rcls/blinky/blinky.kicad_pcb

## KiCad design blinky.kicad_pcb (2025-12-23)

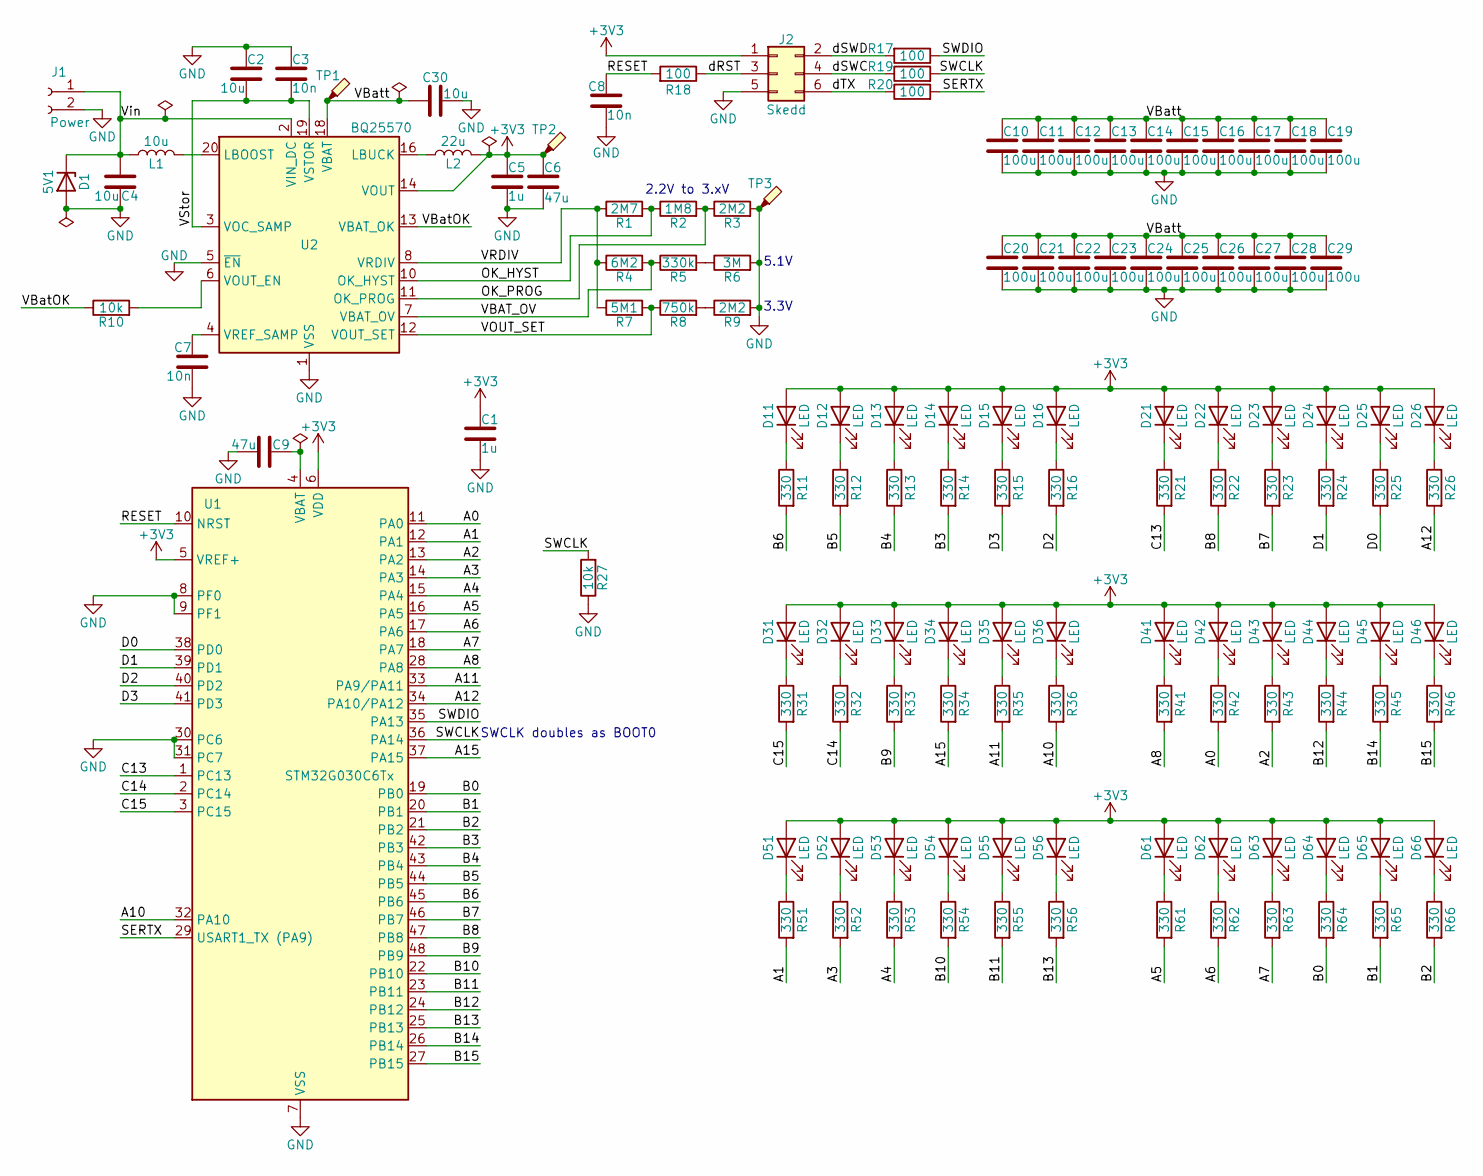
[picture p1: schematic blinky.kicad_sch]

Parts:
C1, C5: 1u; C_0402_1005Metric; LCSC C52923
C2, C4, C30: 10u; C_0603_1608Metric; LCSC C19702
C3, C7, C8: 10n; C_0402_1005Metric; LCSC C15195
C6, C9: 47u; C_0805_2012Metric; LCSC C16780
C10, C11, C12, C13, C14, C15, C16, C17, C18, C19, C20, C21, C22, C23, C24, C25, C26, C27, C28, C29: 100u; C_1206_3216Metric; LCSC C15008
D1: 5V1; D_SOD-323; LCSC C19077434
D11, D12, D13, D14, D15, D16, D21, D22, D23, D24, D25, D26, D31, D32, D33, D34, D35, D36, D41, D42, D43, D44, D45, D46, D51, D52, D53, D54, D55, D56, D61, D62, D63, D64, D65, D66: LED; LED_0805_2012Metric
J1: Power; PinSocket_1x02_P2.54mm_Vertical
J2: Skedd; Skedd6
L1: 10u; L_1008_2520Metric-Adjusted; LCSC C18221303
L2: 22u; L_1008_2520Metric-Adjusted; LCSC C18221305
R1: 2M7; R_0603_1608Metric
R2: 1M8; R_0603_1608Metric
R3, R9: 2M2; R_0603_1608Metric; LCSC C22938
R4: 6M2; R_0603_1608Metric
R5: 330k; R_0603_1608Metric; LCSC C23137
R6: 3M; R_0603_1608Metric; LCSC C23156
R7: 5M1; R_0603_1608Metric; LCSC C13320
R8: 750k; R_0603_1608Metric; LCSC C23240
R10, R27: 10k; R_0402_1005Metric; LCSC C25744
R11, R12, R13, R14, R15, R16, R21, R22, R23, R24, R25, R26, R31, R32, R33, R34, R35, R36, R41, R42, R43, R44, R45, R46, R51, R52, R53, R54, R55, R56, R61, R62, R63, R64, R65, R66: 330; R_0402_1005Metric; LCSC C25104
R17, R18, R19, R20: 100; R_0402_1005Metric; LCSC C25076
TP1, TP2, TP3: TestPoint_Probe; TestPoint
U1: STM32G030C6Tx; LQFP-48_7x7mm_P0.5mm; LCSC C529329
U2: BQ25570; QFN-20-1EP_3.5x3.5mm_P0.5mm_EP2x2mm; LCSC C506250

Connections:
+3V3: C1.1, C5.1, C6.1, D11.2 (A), D12.2 (A), D13.2 (A), D14.2 (A), D15.2 (A), D16.2 (A), D21.2 (A), D22.2 (A), D23.2 (A), D24.2 (A), D25.2 (A), D26.2 (A), D31.2 (A), D32.2 (A), D33.2 (A), D34.2 (A), D35.2 (A), D36.2 (A), D41.2 (A), D42.2 (A), D43.2 (A), D44.2 (A), D45.2 (A), D46.2 (A), D51.2 (A), D52.2 (A), D53.2 (A), D54.2 (A), D55.2 (A), D56.2 (A), D61.2 (A), D62.2 (A), D63.2 (A), D64.2 (A), D65.2 (A), D66.2 (A), J2.1, L2.2, TP2.1, U1.5 (VREF+), U1.6 (VDD), U2.14 (VOUT)
/A0: R42.2, U1.11 (PA0)
/A1: R51.2, U1.12 (PA1)
/A2: R43.2, U1.13 (PA2)
/A3: R52.2, U1.14 (PA3)
/A4: R53.2, U1.15 (PA4)
/A5: R61.2, U1.16 (PA5)
/A6: R62.2, U1.17 (PA6)
/A7: R63.2, U1.18 (PA7)
/A8: R41.2, U1.28 (PA8)
/A10: R36.2, U1.32 (PA10)
/A11: R35.2, U1.33 (PA9/PA11)
/A12: R26.2, U1.34 (PA10/PA12)
/A15: R34.2, U1.37 (PA15)
/B0: R64.2, U1.19 (PB0)
/B1: R65.2, U1.20 (PB1)
/B2: R66.2, U1.21 (PB2)
/B3: R14.2, U1.42 (PB3)
/B4: R13.2, U1.43 (PB4)
/B5: R12.2, U1.44 (PB5)
/B6: R11.2, U1.45 (PB6)
/B7: R23.2, U1.46 (PB7)
/B8: R22.2, U1.47 (PB8)
/B9: R33.2, U1.48 (PB9)
/B10: R54.2, U1.22 (PB10)
/B11: R55.2, U1.23 (PB11)
/B12: R44.2, U1.24 (PB12)
/B13: R56.2, U1.25 (PB13)
/B14: R45.2, U1.26 (PB14)
/B15: R46.2, U1.27 (PB15)
/C13: R21.2, U1.1 (PC13)
/C14: R32.2, U1.2 (PC14)
/C15: R31.2, U1.3 (PC15)
/D0: R25.2, U1.38 (PD0)
/D1: R24.2, U1.39 (PD1)
/D2: R16.2, U1.40 (PD2)
/D3: R15.2, U1.41 (PD3)
/OK_HYST: R1.2, R2.1, U2.10 (OK_HYST)
/OK_PROG: R2.2, R3.1, U2.11 (OK_PROG)
/RESET: C8.1, R18.2, U1.10 (NRST)
/SERTX: R20.2, U1.29 (USART1_TX (PA9))
/SWCLK: R19.2, R27.2, U1.36 (PA14)
/SWDIO: R17.1, U1.35 (PA13)
/VBAT_OV: R4.2, R5.1, U2.7 (VBAT_OV)
/VBatOK: R10.1, U2.13 (VBAT_OK)
/VBatt: C10.1, C11.1, C12.1, C13.1, C14.1, C15.1, C16.1, C17.1, C18.1, C19.1, C20.1, C21.1, C22.1, C23.1, C24.1, C25.1, C26.1, C27.1, C28.1, C29.1, C30.1, TP1.1, U2.18 (VBAT)
/VOUT_SET: R7.2, R8.1, U2.12 (VOUT_SET)
/VRDIV: R1.1, R4.1, R7.1, U2.8 (VRDIV)
/VStor: C2.2, C3.2, U2.3 (VOC_SAMP), U2.19 (VSTOR)
/Vin: C4.1, D1.1 (K), J1.1, L1.1, U2.2 (VIN_DC)
/dRST: J2.3, R18.1
/dSWC: J2.4, R19.1
/dSWD: J2.2, R17.2
/dTX: J2.6, R20.1
GND: C1.2, C2.1, C3.1, C4.2, C5.2, C6.2, C7.2, C8.2, C9.1, C10.2, C11.2, C12.2, C13.2, C14.2, C15.2, C16.2, C17.2, C18.2, C19.2, C20.2, C21.2, C22.2, C23.2, C24.2, C25.2, C26.2, C27.2, C28.2, C29.2, C30.2, D1.2 (A), J1.2, J2.5, R3.2, R6.2, R9.2, R27.1, TP3.1, U1.7 (VSS), U1.8 (PF0), U1.9 (PF1), U1.30 (PC6), U1.31 (PC7), U2.1 (VSS), U2.5 (~EN), U2.9 (VSS), U2.15 (VSS), U2.17 (VSS), U2.21 (VSS)
unnamed: D11.1 (K), R11.1
unnamed: D12.1 (K), R12.1
unnamed: D13.1 (K), R13.1
unnamed: D14.1 (K), R14.1
unnamed: D15.1 (K), R15.1
unnamed: D16.1 (K), R16.1
unnamed: D21.1 (K), R21.1
unnamed: D22.1 (K), R22.1
unnamed: D23.1 (K), R23.1
unnamed: D24.1 (K), R24.1
unnamed: D25.1 (K), R25.1
unnamed: D26.1 (K), R26.1
unnamed: D31.1 (K), R31.1
unnamed: D32.1 (K), R32.1
unnamed: D33.1 (K), R33.1
unnamed: D34.1 (K), R34.1
unnamed: D35.1 (K), R35.1
unnamed: D36.1 (K), R36.1
unnamed: D41.1 (K), R41.1
unnamed: D42.1 (K), R42.1
unnamed: D43.1 (K), R43.1
unnamed: D44.1 (K), R44.1
unnamed: D45.1 (K), R45.1
unnamed: D46.1 (K), R46.1
unnamed: D51.1 (K), R51.1
unnamed: D52.1 (K), R52.1
unnamed: D53.1 (K), R53.1
unnamed: D54.1 (K), R54.1
unnamed: D55.1 (K), R55.1
unnamed: D56.1 (K), R56.1
unnamed: D61.1 (K), R61.1
unnamed: D62.1 (K), R62.1
unnamed: D63.1 (K), R63.1
unnamed: D64.1 (K), R64.1
unnamed: D65.1 (K), R65.1
unnamed: D66.1 (K), R66.1
unnamed: R5.2, R6.1
unnamed: R8.2, R9.1
unnamed: C9.2, U1.4 (VBAT)
unnamed: L1.2, U2.20 (LBOOST)
unnamed: L2.1, U2.16 (LBUCK)
unnamed: R10.2, U2.6 (VOUT_EN)
unnamed: C7.1, U2.4 (VREF_SAMP)

Notes on the sheet:
5.1V
3.3V
2.2V to 3.xV
SWCLK doubles as BOOT0

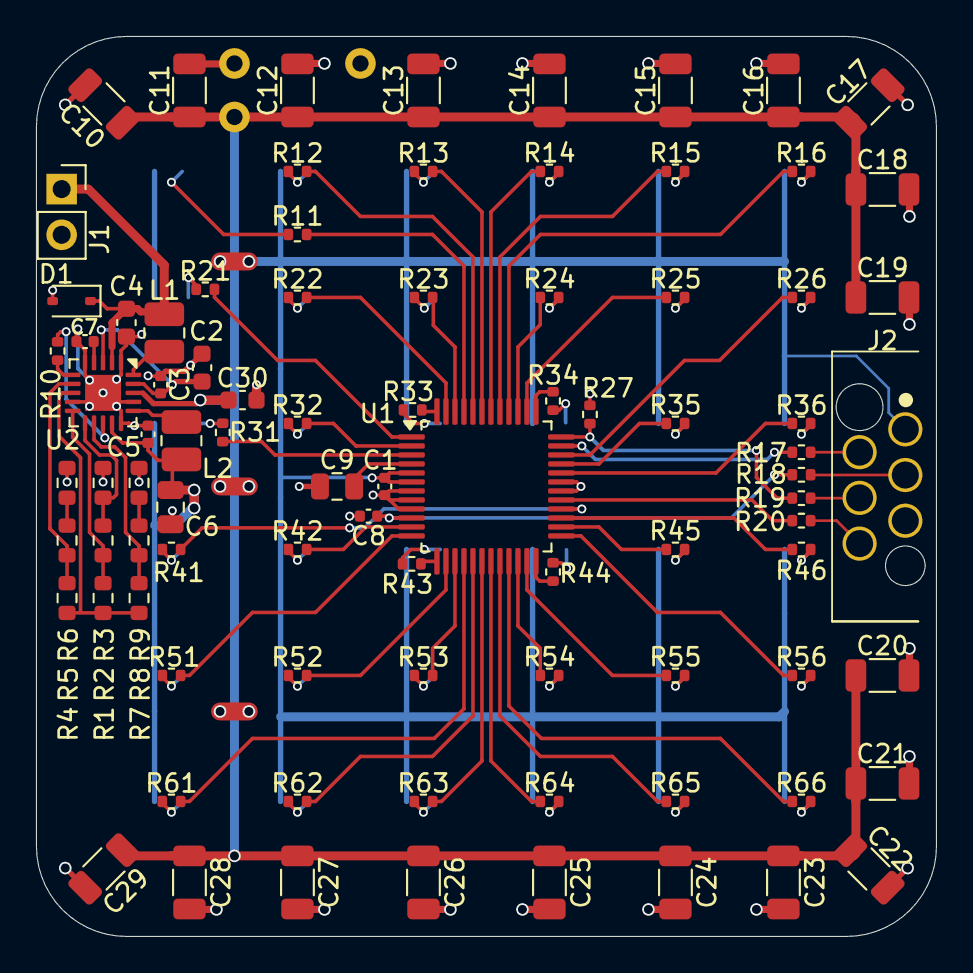
[picture p2: board blinky.kicad_pcb from above]

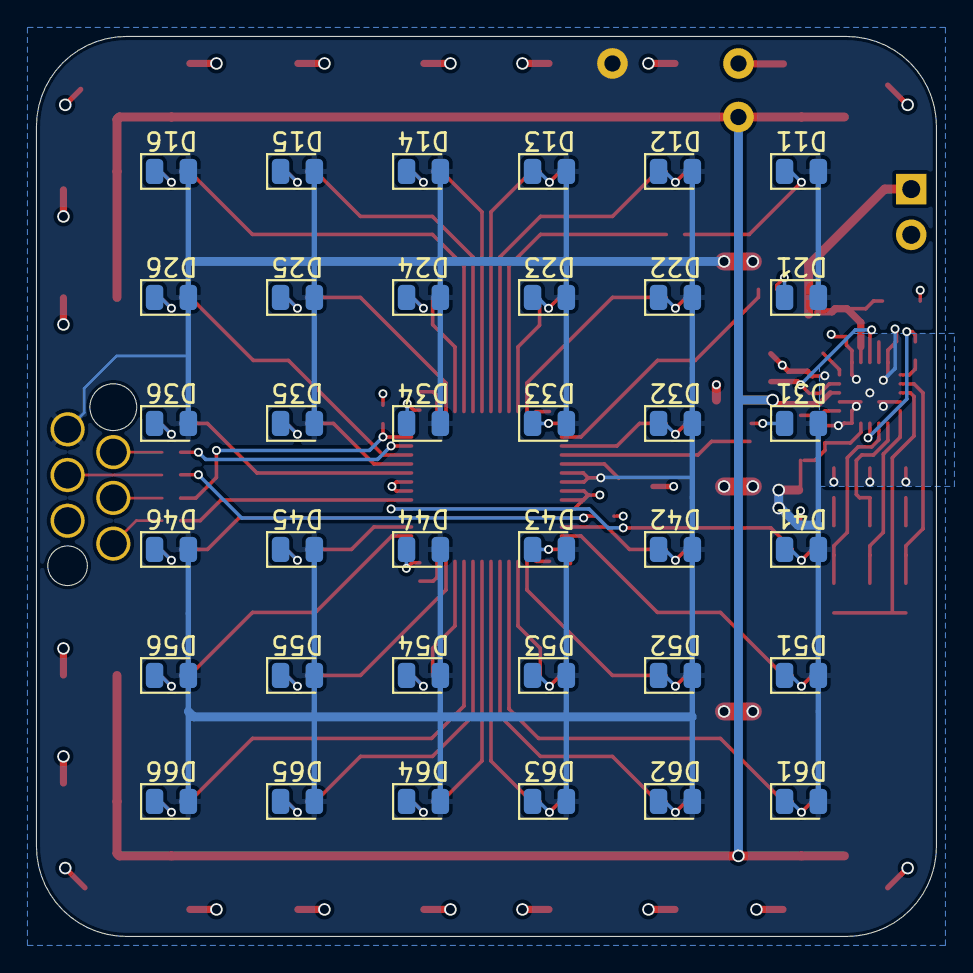
[picture p3: board blinky.kicad_pcb from below]

Board: 4 copper layers, 50.0 x 50.0 mm, 127 parts (37 on the bottom side), 98 nets.
