rcls/blinky/src/leds.rs

pub static COLUMNS: [[u64; 64]; 6] = gen_columns();

const fn gen_columns() -> [[u64; 64]; 6] {
    let mut value = [[0; _]; _];
    let mut column = 0;
    while column < 6 {
        let mut bits = 0;
        while bits < 64 {
            let val = &mut value[column][bits];
            let mut row = 0;
            while row < 6 {
                if bits & (1 << row) != 0 {
                    *val |= 1 << LEDS[column + 30 - row * 6];
                }
                row += 1;
            }
            bits += 1;
        }
        column += 1;
    }
    value
}

/// Bit mask of LED GPIOs.  One entry per-port, successive bits are LEDs.
pub const PORT_BITS: [u32; 4] = PORT_STUFF.0;
/// Like PORT_BITS, except only even numbered bits are used.
pub const PORT_BIT2: [u32; 4] = PORT_STUFF.1;
/// Like PORT_BITS, except only every fourth bit is used.
pub const _PORT_BIT4: [[u32; 2]; 4] = PORT_STUFF.2;

/// Return GPIOA ..= GPIOD based on n.
pub fn gpio(n: usize) -> &'static stm32g030::gpiob::RegisterBlock {
    let address = 0x5000_0000 + 0x400 * n as usize;
    unsafe {&* (address as *const stm32g030::gpiob::RegisterBlock)}
}

pub const PORT_STUFF: ([u32; 4], [u32; 4], [[u32; 2]; 4]) = {
    let mut mask = [0; 4];
    let mut bit2 = [0; 4];
    let mut bit4 = [[0, 2]; 4];
    let mut i = 0;
    while i < LEDS.len() {
        let led = LEDS[i] as usize;
        mask[led / 16] |= 1 << led % 16;
        bit2[led / 16] |= 1 << led % 16 * 2;
        bit4[led / 16][led % 16 / 8] |= 1 << led % 8 * 4;
        i += 1;
    }
    (mask, bit2, bit4)
};

pub const LED_ALL: u64 = {
    let mut all = 0;
    let mut i = 0;
    while i < LEDS.len() {
        all |= 1 << LEDS[i];
        i += 1;
    }
    all
};

const A: u8 = 0;
const B: u8 = 16;
const C: u8 = 32;
const D: u8 = 48;

// First items in the array are D11 .. D16.
pub static LEDS: [u8; 36] = [
    B +  6, B +  5, B + 4, B +  3, D +  3, D +  2,
    C + 13, B +  8, B + 7, D +  1, D +  0, A + 12,
    C + 15, C + 14, B + 9, A + 15, A + 11, A + 10,
    A +  8, A +  0, A + 2, B + 12, B + 14, B + 15,
    A +  1, A +  3, A + 4, B + 10, B + 11, B + 13,
    A +  5, A +  6, A + 7, B +  0, B +  1, B +  2,
];

#[test]
fn unique() {
    let mut leds = LEDS;
    leds.sort();
    for i in 1 .. leds.len() {
        assert_ne!(leds[i], leds[i - 1]);
    }
}

#[test]
fn bit_counts() {
    assert_eq!(LED_ALL.count_ones(), 36);
}

#[test]
fn sane_columns() {
    for column in COLUMNS {
        for (i, x) in column.iter().enumerate() {
            assert_eq!(i.count_ones(), x.count_ones());
            for (j, y) in column.iter().enumerate() {
                assert_eq!(column[i | j], x | y);
            }
        }
    }
}
