rcls/blinky/src/blinky.rs

#![cfg_attr(target_os = "none", no_std)]
#![cfg_attr(target_os = "none", no_main)]

// For link_llvm_intrinsics.
#![allow(internal_features)]
// I value sane syntax over appeasing the Rust Gods.
#![allow(unpredictable_function_pointer_comparisons)]
// We do lots of const.
#![feature(derive_const)]
#![feature(const_cmp, const_convert, const_default, const_trait_impl)]
// For frameaddress() in the crash handler.
#![feature(link_llvm_intrinsics)]

use crate::marque::{marque_string, rmarque_string};
use crate::pendsv::{FIFTH, SECOND, animate, hold_display};

mod adc;
mod chars;
mod cpu;
mod config;
mod debug;
mod leds;
mod marque;
mod pendsv;
mod pulse;
mod random;

/// Flag for global enable/disable of debugging.
const DEBUG_ENABLE: bool = !CONFIG.no_debug;

const CONFIG: cpu::Config =
    *cpu::Config::new(250_000).adc().no_debug().pendsv().pulse();

/// Entry point used by the dbg! and dbgln! macros.
fn debug_fmt(fmt: core::fmt::Arguments) {
    if DEBUG_ENABLE {
        stm_common::debug::debug_fmt::<debug::DebugMeta>(fmt);
    }
}

/// Sequence LEDs on demo board....
fn demo() {
    let mut d = 14 << 40;
    for _ in 0 .. 6 {
        pendsv::hold_display(d, SECOND);
        d >>= 8;
    }
    pendsv::hold_display(0x10 << 16, SECOND);
    pendsv::hold_display(0x10 << 24, SECOND);
}

fn blink_in() {
    for _ in 0 .. 5 {
        hold_display(0, 1);
        hold_display(chars::CDOT, FIFTH);
    }
}

fn cycles() {
    for _ in 0 .. 3 {
        animate(&chars::IDOTS, FIFTH);
    }
    hold_display(chars::MDOTS, FIFTH);
    for _ in 0 .. 1 {
        animate(&chars::ODOTPS, FIFTH);
    }
    animate(&chars::ODOTPS[0 .. 4], FIFTH);
    hold_display(chars::FOUR_DOTS, FIFTH);
}

fn finish() {
    hold_display(0, FIFTH);
    animate(&[chars::CORNERS, chars::FOUR_IDOTS, chars::CDOT], 2 * FIFTH);
    hold_display(0, FIFTH);
}

fn nice1() {
    const I: u64 = chars::picture('I');
    const U: u64 = chars::picture('U');
    hold_display(I, 2 * SECOND);
    for _ in 0 .. 5 {
        hold_display(0, FIFTH);
        hold_display(chars::LOVE, FIFTH);
    }
    hold_display(0, FIFTH);
    hold_display(U, 2 * SECOND);
}

fn nice2() {
    const STR: &[u8] = &chars::map_str(b"LOOKING GOOD ");
    rmarque_string(STR, FIFTH);
}

fn nice3() {
    const STR: &[u8] = &chars::map_str(b"NICE HAIR ");
    rmarque_string(STR, FIFTH);
}

fn nice4() {
    const STR: &[u8] = &chars::map_str(b"KISS ME ");
    rmarque_string(STR, FIFTH);
}

fn nice5() {
    const STR: &[u8] = &chars::map_str(b"PEACE ");
    rmarque_string(STR, FIFTH);
}

fn naughty1() {
    const STR: &[u8] = &chars::map_str(b"WHO FARTED? ");
    rmarque_string(STR, FIFTH);
}

fn naughty2() {
    const STR: &[u8] = &chars::map_str(b"LICK ME ");
    rmarque_string(STR, FIFTH);
}

/// Returns the future for running the asynchronous application code.
fn run() -> ! {
    if false {
        loop {
            demo();
        }
    }
    if false {
        loop { // Pattern to test LEDs.
            let mut d = 0x3f;
            while d != 0 {
                hold_display(d, 2 * FIFTH);
                d <<= 8;
            }
        }
    }

    blink_in();
    hold_display(0, 1);

    let mut count = 0u32;
    loop {
        count = count.saturating_add(1);
        // Probability of exception ramps from 0 at <5 to ⅔ at 25.
        let normal = count <= 5
            || random::RANDOM.random_n(30) >= count.min(25) - 5;

        if normal {
            const STR: &[u8] = &chars::map_str(b"MERRY XMAS ");
            marque_string(&mut 0, STR, FIFTH);
            hold_display(0, 2);
        }
        else {
            blink_in();
            cycles();
            hold_display(0, FIFTH);
            match random::RANDOM.random_n(7) {
                0 => nice1(),
                1 => nice2(),
                2 => nice3(),
                3 => nice4(),
                4 => nice5(),
                5 => naughty1(),
                6|_ => naughty2(),
            }
            finish();
        }
    }
}

fn main() -> ! {
    let rcc  = unsafe {&*stm32g030::RCC::PTR};

    cpu::init();

    rcc.IOPENR.write(
        |w|w.GPIOAEN().set_bit().GPIOBEN().set_bit().GPIOCEN().set_bit()
            .GPIODEN().set_bit());

    if CONFIG.is_lazy_debug() || CONFIG.no_debug {
        let gpioa = unsafe {&*stm32g030::GPIOA::PTR};
        gpioa.BSRR.write(|w| w.BS9().set_bit());
        gpioa.MODER.write(|w| w.MODER9().bits(1));
    }
    else {
        debug::init();
    }

    for i in 0 .. 4 {
        let gpio = leds::gpio(i);
        let bits = leds::PORT_BITS[i];
        let bit2 = leds::PORT_BIT2[i];
        gpio.BSRR.write(|w| w.bits(bits));
        gpio.MODER.modify(|r, w| w.bits(r.bits() & !(bit2 * 2) | bit2));
    }

    pendsv::init();
    pulse::init();

    run();
}
