rcls/blinky/(commit log)

2025-11-30 Schematic and most routing done.
    [blinky.kicad_pcb, blinky.kicad_sch]
2025-12-01 Sorting out DRC.
    [blinky.kicad_pcb, blinky.kicad_sch]
2025-12-01 Cap to the max.
    [blinky.kicad_pcb, blinky.kicad_sch]
2025-12-01 Sort out resistor values.
    [blinky.kicad_pcb, blinky.kicad_sch]
2025-12-01 Flip debug connector.
    [blinky.kicad_pcb, blinky.kicad_sch]
2025-12-01 Add room for power connector socket.
    Adjust skedd connector foot-print to fit board.
    [blinky.kicad_pcb]
2025-12-01 Use 330 ohm resistors.
    [blinky.kicad_pcb, blinky.kicad_sch]
2025-12-02 Believe the datasheet not the website
    [blinky.kicad_pcb, blinky.kicad_sch]
2025-12-03 Add debug etc.
    Disambiguate variable for python type-checking in filter-pos.
2025-12-04 Move a couple of files to be shared
2025-12-10 Add first cut of characters and interrupt handling.
2025-12-13 Flying with ADC measuring voltage & conditioning pulse length.
2025-12-14 Go to 80Hz.
2025-12-15 Implement an alternative pulsing scheme at low output.
    Doesn't actually work that well.
    [adc.rs, marque.rs, pendsv.rs, pulse.rs]
2025-12-23 Some more animations.
    [blinky.kicad_pcb, blinky.kicad_sch, stand.scad]
2025-12-23 No need for the two phase pwm scheme.
